benoitjoh/latchControl/(commit log)

2019-01-13 find a way to achive 200ns for the short pulse
    [LatchControl.cpp, LatchControl.h, latch1w.ino]
2019-01-13 remove support for 2 wire variant
2019-01-17 use smaller capacitors
2019-10-01 implement variant with two data wires
2023-01-16 bug in detection of wire parameter
    [LatchControl.cpp]
